vasili-v/ssd-ps-33/README.md

# Schematics for Synchronous Step-Down DC-DC Power Supply

## About

The repository contains a schematic for the Synchronous Step-Down DC-DC Power Supply with 3.6-16V input and 3.3V, 3A max output designed to operate from 4 to 8 AA or AAA batteries.
