vasili-v/ssd-ps-33/ssd-ps-33.kicad_pcb

## KiCad design ssd-ps-33.kicad_pcb (2026-04-27)

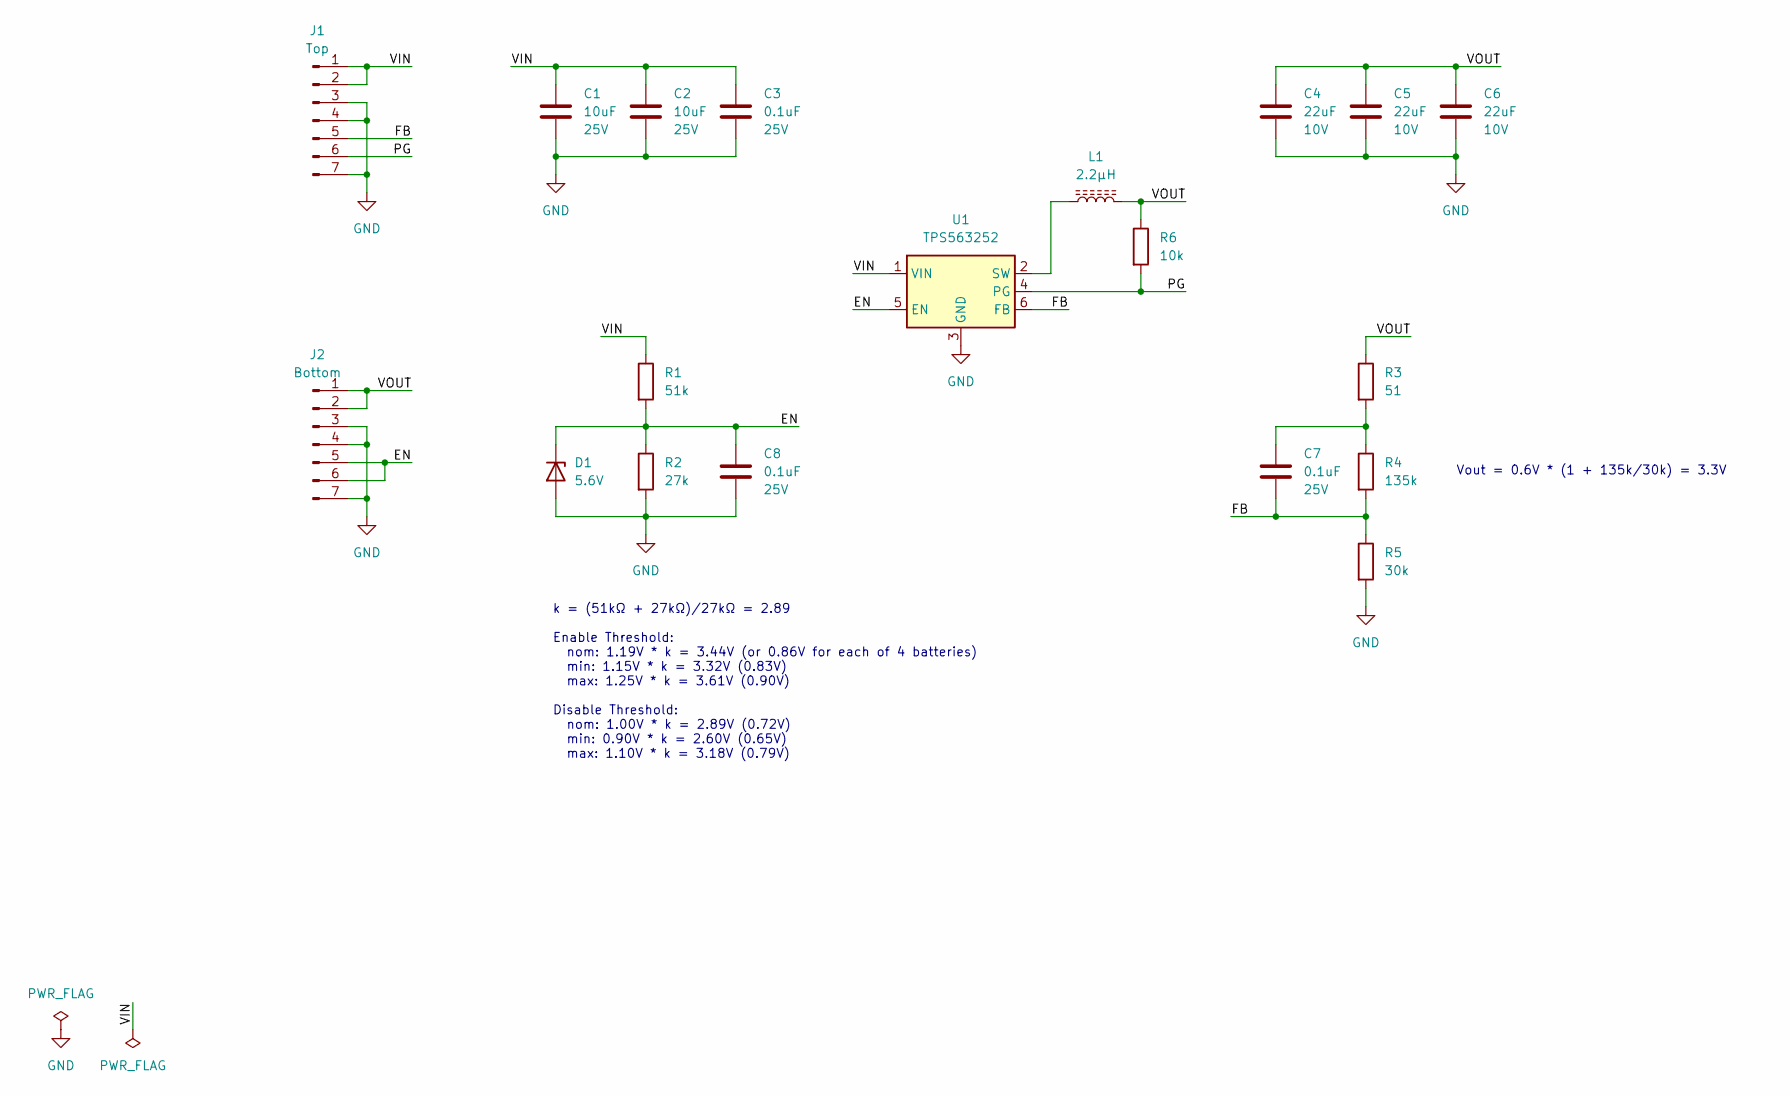
[picture p1: schematic ssd-ps-33.kicad_sch, Synchronous Step-Down 3.3V Power Supply]

Parts:
C1, C2: 10uF; C_0805_2012Metric; Rated Voltage 25V; Part Number GRM21BR61E106MA73L
C3, C7, C8: 0.1uF; C_0603_1608Metric_Pad1.08x0.95mm_HandSolder; Rated Voltage 25V; Part Number CC0603KRX7R8BB104
C4, C5, C6: 22uF; C_0805_2012Metric; Rated Voltage 10V; Part Number GRM21BR61A226ME44L
D1: 5.6V; D_SOD-323_HandSoldering
J1: Top; PinHeader_1x07_P2.54mm_Vertical_No_Silkscreen
J2: Bottom; PinHeader_1x07_P2.54mm_Vertical_No_Silkscreen
L1: 2.2µH; L_Chilisin_BWVS00505040; Part Number BWVS005050402R2M00
R1: 51k; R_0603_1608Metric_Pad0.98x0.95mm_HandSolder
R2: 27k; R_0603_1608Metric_Pad0.98x0.95mm_HandSolder
R3: 51; R_0603_1608Metric_Pad0.98x0.95mm_HandSolder
R4: 135k; R_0603_1608Metric_Pad0.98x0.95mm_HandSolder
R5: 30k; R_0603_1608Metric_Pad0.98x0.95mm_HandSolder
R6: 10k; R_0603_1608Metric_Pad0.98x0.95mm_HandSolder
U1: TPS563252; SOT-563; Part Number TPS563252DRLR

Connections:
/EN: C8.1, D1.1 (K), J2.5, J2.6, R1.2, R2.1, U1.5 (EN)
/FB: C7.2, J1.5, R4.2, R5.1, U1.6 (FB)
/PG: J1.6, R6.2, U1.4 (PG)
/VIN: C1.1, C2.1, C3.1, J1.1, J1.2, R1.1, U1.1 (VIN)
/VOUT: C4.1, C5.1, C6.1, J2.1, J2.2, L1.2, R3.1, R6.1
GND: C1.2, C2.2, C3.2, C4.2, C5.2, C6.2, C8.2, D1.2 (A), J1.3, J1.4, J1.7, J2.3, J2.4, J2.7, R2.2, R5.2, U1.3 (GND)
unnamed: C7.1, R3.2, R4.1
unnamed: L1.1, U1.2 (SW)

Notes on the sheet:
Vout = 0.6V * (1 + 135k/30k) = 3.3V
k = (51kΩ + 27kΩ)/27kΩ = 2.89 Enable Threshold: nom: 1.19V * k = 3.44V (or 0.86V for each of 4 batteries) min: 1.15V * k = 3.32V (0.83V) max: 1.25V * k = 3.61V (0.90V) Disable Threshold: nom: 1.00V * k = 2.89V (0.72V) min: 0.90V * k = 2.60V (0.65V) max: 1.10V * k = 3.18V (0.79V)

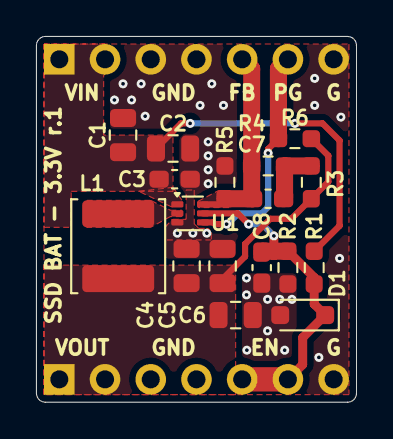
[picture p2: board ssd-ps-33.kicad_pcb from above]

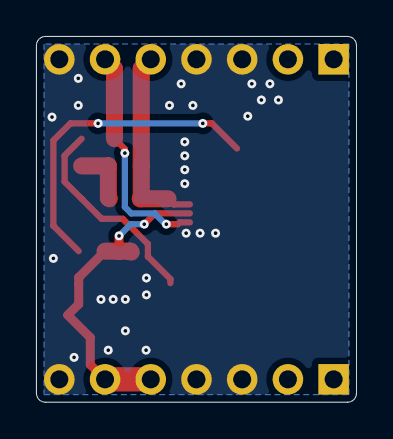
[picture p3: board ssd-ps-33.kicad_pcb from below]

Board: 2 copper layers, 17.8 x 20.3 mm, 19 parts (2 on the bottom side), 8 nets.
