vasili-v/ssd-ps-33/(commit log)

2026-04-14 Add initial KiCad project files
    [ssd-ps-33.kicad_pcb, ssd-ps-33.kicad_sch]
2026-04-15 Put controller and filter capacitors to schematic
    [ssd-ps-33.kicad_sch]
2026-04-16 Create main schematics without connectors for now
    [ssd-ps-33.kicad_sch]
2026-04-16 Preliminary place components
    [ssd-ps-33.kicad_pcb]
2026-04-24 Draft routing, board size and select connectors
    [ssd-ps-33.kicad_pcb, ssd-ps-33.kicad_sch]
2026-04-24 Set values for enable network and fix DRC errors
    [ssd-ps-33.kicad_pcb, ssd-ps-33.kicad_sch]
2026-04-24 Place part's references
    [ssd-ps-33.kicad_pcb]
2026-04-26 Add designators to pins and board name
    [ssd-ps-33.kicad_pcb, ssd-ps-33.kicad_sch]
2026-04-26 Change board name and add revision
    [ssd-ps-33.kicad_pcb]
2026-04-27 Add FB to top connector and finalize routing
    [ssd-ps-33.kicad_pcb, ssd-ps-33.kicad_sch]
2026-04-27 Round PCB corners
    [ssd-ps-33.kicad_pcb]
2026-04-27 Setup fabrication output
    [ssd-ps-33.kicad_pcb]
2026-04-28 Complete BOM with market available parts
    [ssd-ps-33.kicad_sch]
